xtracool/trs80-m1-drive-monitor/sa400_led_monitor/pdf/schematic.tex

% schematic.tex — one-page schematic of sa400_led_monitor v0.2.2, as built (JLCPCB r2 BOM).
% Hand-drawn with circuitikz from the netlist in gen/design.py; pin numbers are the DIP pins.
% Build:  lualatex schematic.tex   (pdf/build_test_plan.py does this and copies the PDF to docs/img/)
\documentclass[border=6pt]{standalone}
\usepackage{fontspec}
\setmainfont{DejaVu Sans}[Path=/usr/share/fonts/truetype/dejavu/,Extension=.ttf,UprightFont=*,BoldFont=*-Bold,ItalicFont=*-Oblique,BoldItalicFont=*-BoldOblique]
\usepackage[american]{circuitikz}
\usetikzlibrary{calc}
\ctikzset{bipoles/length=0.85cm, logic ports/scale=0.75, logic ports/fill=white}
\tikzset{every node/.style={font=\footnotesize}, pin/.style={font=\scriptsize, inner sep=1pt, text=black!70}}
\newcommand{\gnd}[1]{node[ground, scale=0.8]{}}
\begin{document}
\begin{circuitikz}[x=1cm, y=1cm]
% ===================================================================== title
\node[anchor=west, font=\normalsize\bfseries] at (0,2.3) {sa400\_led\_monitor v0.2.3 boards --- schematic, as built (r2 BOM)};
\node[anchor=west, font=\tiny, text=black!70] at (0,1.85) {Bus signals are active-low, open-collector, terminated 150~$\Omega$ at the last drive. This board: high-impedance tap, no terminators, never drives the bus. All gate pin numbers are DIP-14 pins.};

% ===================================================================== power
\draw[thick] (0,0.5) rectangle (1.0,-3.0);
\node[font=\scriptsize\bfseries] at (0.5,0.22) {J2};
\node[font=\tiny, rotate=90] at (0.42,-1.6) {Mate-N-Lok};
\foreach \y/\p/\n in {0/4/+5\,V, -0.6/3/RTN, -1.2/2/RTN, -2.4/1/+12\,V} {
  \draw (1.0,\y) -- (1.4,\y);
  \node[pin, anchor=east] at (0.97,\y) {\p};
}
\node[pin, anchor=south west] at (1.0,0.02) {+5\,V in};
\node[pin, anchor=north west] at (1.0,-2.42) {+12\,V in};
\node[pin, anchor=west] at (1.75,-0.9) {2, 3 RTN};
% returns
\draw (1.4,-0.6) -- (1.4,-1.2) -- (1.4,-1.45) \gnd{};
% +5 V chain
\draw (1.4,0) to[fuse, l=F1 PTC 0.5\,A] (3.2,0) -- (3.55,0);
\node[pigfete, bodydiode, rotate=90, yscale=-1] (q1) at (4.3,0.05) {};
\draw (3.55,0) -- (q1.D);
\node[pin, anchor=south] at ($(q1.D)+(0.05,0.08)$) {D};
\node[pin, anchor=south] at ($(q1.S)+(-0.05,0.08)$) {S};
\node[pin, anchor=east] at ($(q1.G)+(-0.05,0.25)$) {G};
\node[font=\scriptsize, anchor=south] at (4.3,0.78) {Q1 IRF4905 (P-ch) {\tiny --- reverse-polarity switch}};
\draw (q1.G) -- ($(q1.G)+(0,-0.25)$) \gnd{};
\draw (q1.S) -- (5.6,0) node[circ]{} node[pin, anchor=south east] {+5V} -- (13.0,0) node[vcc, scale=0.8]{+5\,V rail};
% clamp and decoupling
\draw (6.2,-2.0) to[zD, l_=D11 5V6] (6.2,0) node[circ]{};
\draw (6.2,-2.0) \gnd{};
\draw (8.2,0) node[circ]{} to[C, l=C6 100n] (8.2,-2.0) \gnd{};
\draw (10.1,0) node[circ]{} to[eC, l=C4 10$\mu$] (10.1,-2.0) \gnd{};
\draw (11.8,0) node[circ]{} to[R, l=R21 470] (11.8,-1.2) to[leD, l=D13 Y] (11.8,-2.3) \gnd{};
\node[pin, anchor=north] at (11.8,-2.75) {"5V"};
% +12 V indicator
\draw (1.4,-2.4) to[R, l_=R19 2k2] (2.7,-2.4) to[leD, l_=D12 Y] (3.9,-2.4) -- (4.3,-2.4) -- (4.3,-2.7) \gnd{};
\node[pin, anchor=north] at (4.3,-3.15) {"12V"};
\node[font=\tiny, text=black!70, anchor=north west, align=left] at (5.3,-3.15) {+12\,V lights D12 only --- nothing else on the board uses it.\\ +5\,V: J2-4 $\to$ F1 $\to$ Q1 $\to$ rail; D11 clamps the rail (74LS abs.\ max 7\,V).\\ C1, C2, C3 100n: pin 14 $\to$ pin 7 at U1, U2, U3 (not drawn).};

% ===================================================================== bus side: J1 bar
\draw[thick] (-0.1,-4.4) rectangle (0.9,-17.1);
\node[font=\scriptsize\bfseries, rotate=90] at (0.22,-6.8) {J1 34-pin card edge};
\node[font=\tiny, rotate=90, text=black!70, align=center] at (0.22,-12.0) {odd pins 3--31 = GND\\ even pins not listed: no copper\\ 1, 33: no connect};
\draw (0.9,-16.7) -- (1.3,-16.7) -- (1.3,-16.95) \gnd{};
\node[pin, anchor=south west] at (0.95,-16.68) {3,5,\dots,31};

% ===================================================================== WRITE GATE receiver
\draw (0.9,-4.9) node[pin, anchor=east] {24} -- (1.3,-4.9) to[R, l_=R14 470] (2.8,-4.9) node[circ] (wgin) {};
\draw (wgin) to[R, l_=R13 10k] (2.8,-3.7) node[vcc, scale=0.7]{+5\,V};
\node[invschmitt port] (u1wg) at (4.0,-4.9) {};
\draw (wgin) -- (u1wg.in 1);
\node[pin, anchor=south east] at ($(u1wg.in 1)+(0.12,0.04)$) {11};
\node[pin, anchor=south west] at ($(u1wg.out)+(-0.12,0.06)$) {10};
\node[font=\tiny, anchor=north] at (4.0,-5.35) {U1f 74LS14};
\draw (u1wg.out) -- (5.6,-4.9) node[circ]{} node[pin, anchor=south west]{WG (high = writing)};
\node[font=\tiny, text=black!70, anchor=south west] at (1.0,-4.85) {WG\_n};

% ===================================================================== four drive channels
% n / J1 pin / series R / pull-up / U1 in / U1 out / U3 in / U3 out / red LED / red R / NAND in1 / in2 / out / green LED / green R / gate letters
\foreach \n/\fp/\rs/\rp/\ia/\oa/\ib/\ob/\dr/\rr/\na/\nb/\no/\dg/\rg/\ga/\gb/\gc [count=\i] in
  {1/10/R17/R9/1/2/1/2/D1/R1/1/2/3/D5/R5/a/a/a,
   2/12/R16/R10/3/4/3/4/D2/R2/4/5/6/D6/R6/b/b/b,
   3/14/R15/R11/5/6/5/6/D3/R3/9/10/8/D7/R7/c/c/c,
   4/6/R18/R12/9/8/9/8/D4/R4/12/13/11/D8/R8/d/d/d} {
  \pgfmathsetmacro{\y}{-7.1 - (\i-1)*2.75}
  \pgfmathsetmacro{\yg}{\y - 1.35}
  % finger -> series R -> receiver node with pull-up
  \draw (0.9,\y) node[pin, anchor=east] {\fp} -- (1.3,\y) to[R, l_=\rs\ 470] (2.8,\y) node[circ] (in\n) {};
  \node[font=\tiny, text=black!70, anchor=south west] at (1.0,\y+0.05) {DS\n\_n};
  \draw (in\n) to[R, l_=\rp\ 10k] (2.8,\y+1.2) node[vcc, scale=0.7]{+5\,V};
  % U1 receiver
  \node[invschmitt port] (u1\n) at (4.0,\y) {};
  \draw (in\n) -- (u1\n.in 1);
  \node[pin, anchor=south east] at ($(u1\n.in 1)+(0.12,0.04)$) {\ia};
  \node[pin, anchor=south west] at ($(u1\n.out)+(-0.12,0.06)$) {\oa};
  \node[font=\tiny, anchor=north] at (4.0,\y-0.45) {U1\ga\ 74LS14};
  \draw (u1\n.out) -- (5.0,\y) node[circ] (ds\n) {} node[pin, anchor=south]{DS\n};
  % red: U3 open-collector inverter -> red LED -> R -> +5V
  \node[american not port] (u3\n) at (6.6,\y) {};
  \node[jump crossing, scale=2.4] (jc\n) at (5.6,\y) {};
  \draw (ds\n) -- (jc\n.west);  \draw (jc\n.east) -- (u3\n.in 1);
  \node[pin, anchor=south east] at ($(u3\n.in 1)+(0.12,0.04)$) {\ib};
  \node[pin, anchor=south west] at ($(u3\n.out)+(-0.12,0.06)$) {\ob};
  \node[font=\tiny, anchor=north] at (6.6,\y-0.45) {U3\gb\ 74LS06 (OC)};
  \draw (10.9,\y) node[vcc, scale=0.7]{+5\,V} to[R, l=\rr\ 470] (9.4,\y) to[leD, l=\dr\ RED] (u3\n.out);
  \node[pin, anchor=north] at (8.6,\y-0.25) {SEL \n};
  % green: NAND(DSn, WG) -> green LED -> R -> +5V
  \node[american nand port] (u2\n) at (6.6,\yg) {};
  \draw (ds\n) |- (u2\n.in 1);
  \draw (u2\n.in 2) -- (5.6,0 |- u2\n.in 2) node[circ]{};
  \node[pin, anchor=south east] at ($(u2\n.in 1)+(0.12,0.02)$) {\na};
  \node[pin, anchor=north east] at ($(u2\n.in 2)+(0.12,-0.02)$) {\nb};
  \node[pin, anchor=south west] at ($(u2\n.out)+(-0.12,0.06)$) {\no};
  \node[font=\tiny, anchor=north] at (6.6,\yg-0.5) {U2\gc\ 74LS00};
  \draw (10.9,\yg) node[vcc, scale=0.7]{+5\,V} to[R, l=\rg\ 470] (9.4,\yg) to[leD, l=\dg\ GRN] (u2\n.out);
  \node[pin, anchor=north] at (8.6,\yg-0.25) {WR \n};
}
% WG bus, hopping over each DSn -> U3 wire
\draw (5.6,-4.9) -- (jc1.north);
\draw (jc1.south) -- (jc2.north);
\draw (jc2.south) -- (jc3.north);
\draw (jc3.south) -- (jc4.north);
\draw (jc4.south) -- (5.6,-7.1-3*2.75-1.35-0.25);
% unused gates
\node[font=\tiny, text=black!70, anchor=north west, align=left] at (1.0,-17.5) {Unused: U1 pin 13 $\to$ GND (out 12 open); U3 pins 11, 13 $\to$ GND (outs 10, 12 open). Power: pin 14 = +5\,V, pin 7 = GND on U1--U3.\\ Drive $n$ on this board = TRS-80 drive :$n\!-\!1$. LED current $\approx (5 - 0.4 - V_f)/470 \approx 5.5$--$6.5$\,mA. Red = DS$n$; green = DS$n \cdot$ WG.};
\end{circuitikz}
\end{document}
