xtracool/trs80-m1-drive-monitor/sa400_led_monitor/output/ROUTE_REPORT.md

# Route report - sa400_led_monitor v0.2.4

- grid 1.27 mm, clearance 0.3 mm, signal 0.4 mm, power 0.6 mm
- segments: 250, vias: 45

| net | segments | vias | length mm |
|---|---|---|---|
| GND | 68 | 5 | 388.6 |
| +5V | 42 | 7 | 378.5 |
| +12V_IN | 4 | 1 | 55.9 |
| +5V_F | 4 | 0 | 14.0 |
| +5V_IN | 3 | 1 | 27.9 |
| DS1 | 9 | 2 | 109.2 |
| DS1_in | 7 | 0 | 44.4 |
| DS1_n | 1 | 0 | 7.6 |
| DS2 | 7 | 2 | 106.7 |
| DS2_in | 6 | 2 | 48.3 |
| DS2_n | 2 | 0 | 10.2 |
| DS3 | 9 | 1 | 110.5 |
| DS3_in | 8 | 3 | 61.0 |
| DS3_n | 3 | 0 | 12.7 |
| DS4 | 9 | 1 | 115.6 |
| DS4_in | 7 | 3 | 62.2 |
| DS4_n | 1 | 0 | 7.6 |
| GRN1_A | 1 | 0 | 10.2 |
| GRN1_K | 3 | 1 | 54.6 |
| GRN2_A | 1 | 0 | 10.2 |
| GRN2_K | 3 | 0 | 47.0 |
| GRN3_A | 1 | 0 | 10.2 |
| GRN3_K | 2 | 1 | 77.5 |
| GRN4_A | 1 | 0 | 10.2 |
| GRN4_K | 5 | 3 | 110.5 |
| LED12 | 2 | 1 | 14.0 |
| LED5 | 2 | 1 | 14.0 |
| RED1_A | 1 | 0 | 10.2 |
| RED1_K | 3 | 1 | 116.8 |
| RED2_A | 1 | 0 | 10.2 |
| RED2_K | 3 | 2 | 96.5 |
| RED3_A | 1 | 0 | 10.2 |
| RED3_K | 3 | 1 | 76.2 |
| RED4_A | 1 | 0 | 10.2 |
| RED4_K | 5 | 1 | 66.0 |
| WG | 14 | 4 | 137.2 |
| WG_in | 6 | 1 | 39.4 |
| WG_n | 1 | 0 | 7.6 |
| unconnected-(J1-DIR#-Pad18) | 0 | 0 | 0.0 |
| unconnected-(J1-GND-Pad1) | 0 | 0 | 0.0 |
| unconnected-(J1-GND-Pad33) | 0 | 0 | 0.0 |
| unconnected-(J1-INDEX#-Pad8) | 0 | 0 | 0.0 |
| unconnected-(J1-MOTOR_ON#-Pad16) | 0 | 0 | 0.0 |
| unconnected-(J1-RDATA#-Pad30) | 0 | 0 | 0.0 |
| unconnected-(J1-STEP#-Pad20) | 0 | 0 | 0.0 |
| unconnected-(J1-TRK00#-Pad26) | 0 | 0 | 0.0 |
| unconnected-(J1-WDATA#-Pad22) | 0 | 0 | 0.0 |
| unconnected-(J1-WPROT#-Pad28) | 0 | 0 | 0.0 |
| unconnected-(J1-spare-Pad2) | 0 | 0 | 0.0 |
| unconnected-(J1-spare-Pad32) | 0 | 0 | 0.0 |
| unconnected-(J1-spare-Pad34) | 0 | 0 | 0.0 |
| unconnected-(J1-spare-Pad4) | 0 | 0 | 0.0 |
| unconnected-(U1-6Y-Pad12) | 0 | 0 | 0.0 |
| unconnected-(U3-5Y-Pad10) | 0 | 0 | 0.0 |
| unconnected-(U3-6Y-Pad12) | 0 | 0 | 0.0 |
