xtracool/trs80-m1-drive-monitor/sa400_led_monitor/docs/img/fixtures.pdf

## D.1 Bus-simulator jig (“fake EI”) — used in Phase 2

Each monitored line is held high by 150 Ω (as the terminating drive does) and pulled to ground by a switch (as a 7438 in the EI does).
The monitor plugs onto the 3463. Ribbon conductor N = J1 pin N when the stripe is on contact 1 — check with the DMM before trusting the jig. 3M ³⁴⁶³⁻⁰⁰⁰¹ card⁻edge IDC

+5V_JIG bench supply 2 (or the same supply): 5.0 V, 50 mA limit

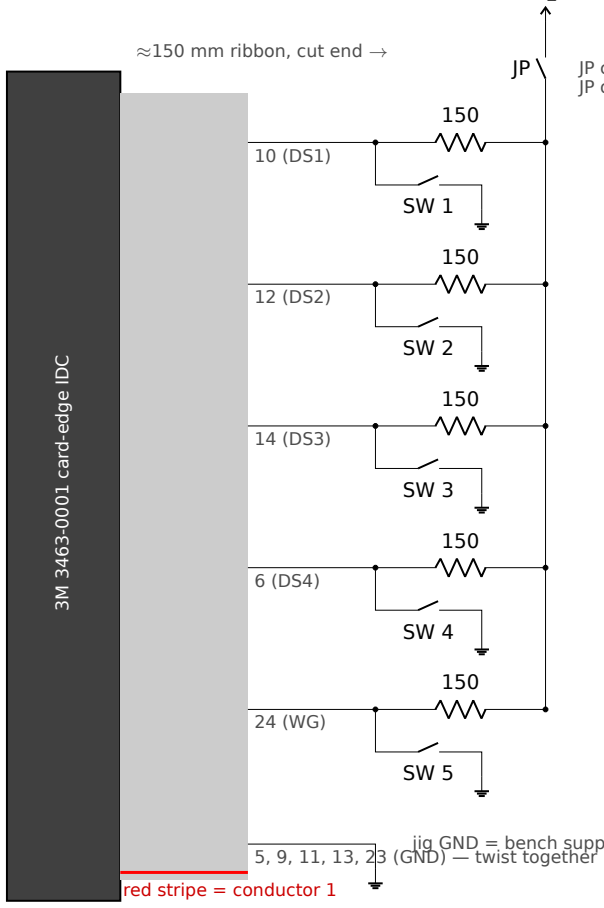
[picture p21: figure]
red stripe = conductor 1; ≈150 mm ribbon, cut end →; 5, 9, 11, 13, 23 (GND) — twist together

JP closed = pull-ups on (terminated bus)
JP open = the board’s own 10 k only

jig GND = bench supply (–) = the monitor supply’s (–): one common ground

Steps 2.6.2 and 2.8: mA meter in place of SW n (line to GND). Step 2.6.22: meter in series with that line’s 150 Ω. Any 34-way 0.1 in card-edge IDC and 28 AWG ribbon will do; parts in Appendix C.

## D.2 Power pigtail for J2 — used in Phases 2 and 3

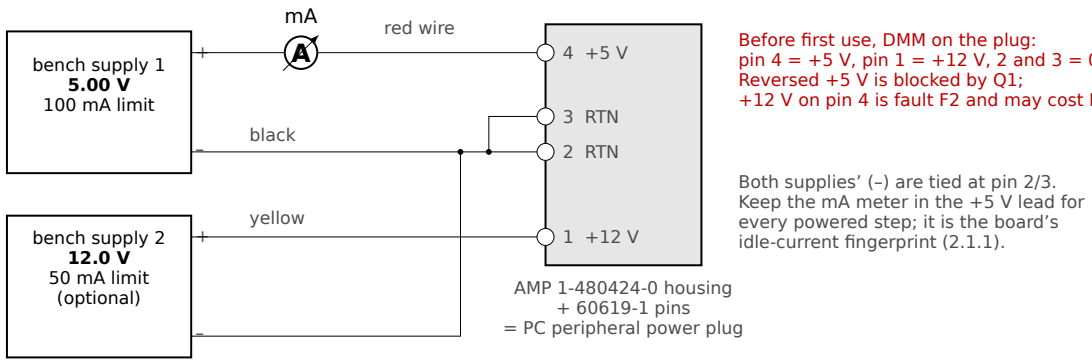
[picture p22: figure]
bench supply 1 5.00 V 100 mA limit; bench supply 2 12.0 V 50 mA limit (optional); 3 RTN; 2 RTN; AMP 1-480424-0 housing + 60619-1 pins = PC peripheral power plug; red wire; black; yellow; Before first use, DMM on the plug:; Reversed +5 V is blocked by Q1;; Both supplies’ (–) are tied at pin 2/3. Keep the mA meter in the +5 V lead for every powered step; it is the board’s idle-current fingerprint (2.1.1).

pin 4 = +5 V, pin 1 = +12 V, 2 and 3 = 0 V.

+12 V on pin 4 is fault F2 and may cost D11.

D.3 Key plug (optional) — 3M 3439-2 in the connector, opposite the board’s slot between fingers 4 and 6

34 32 30 28 26 24 22 20 18 16 14 12 10 8 | 6 | 4 | 2

slot

Board tab seen from the component side, fingers pointing away: pin 2 at the right, even pins on top, odd (GND) underneath. The 3439-2 pushes into the 3463’s contact cavity at that position; the connector then only fits the monitor one way. Without it, the stripe-to-pin-1 check in 3.0 is what prevents a reversed plug.
