xtracool/trs80-m1-drive-monitor/sa400_led_monitor/output/copper_top_bottom.png

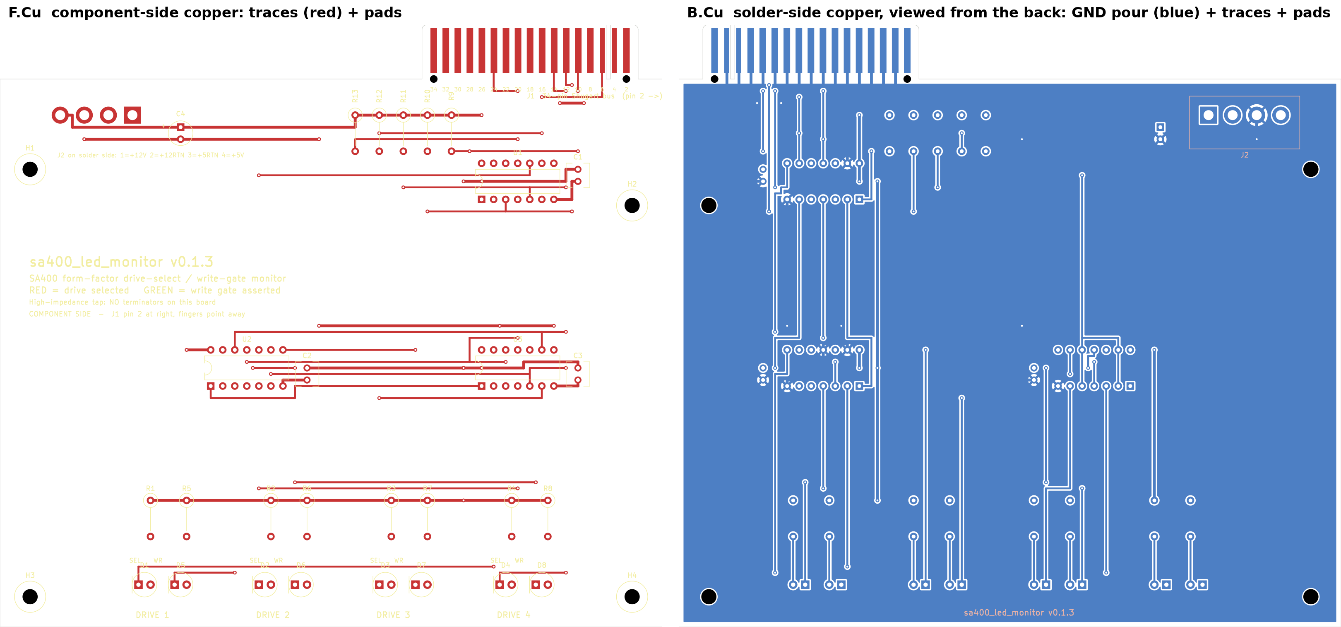
sa400_led_monitor/output/copper_top_bottom.png
