xtracool/trs80-m1-drive-monitor/sa400_led_monitor/output/j1_root_holes.png

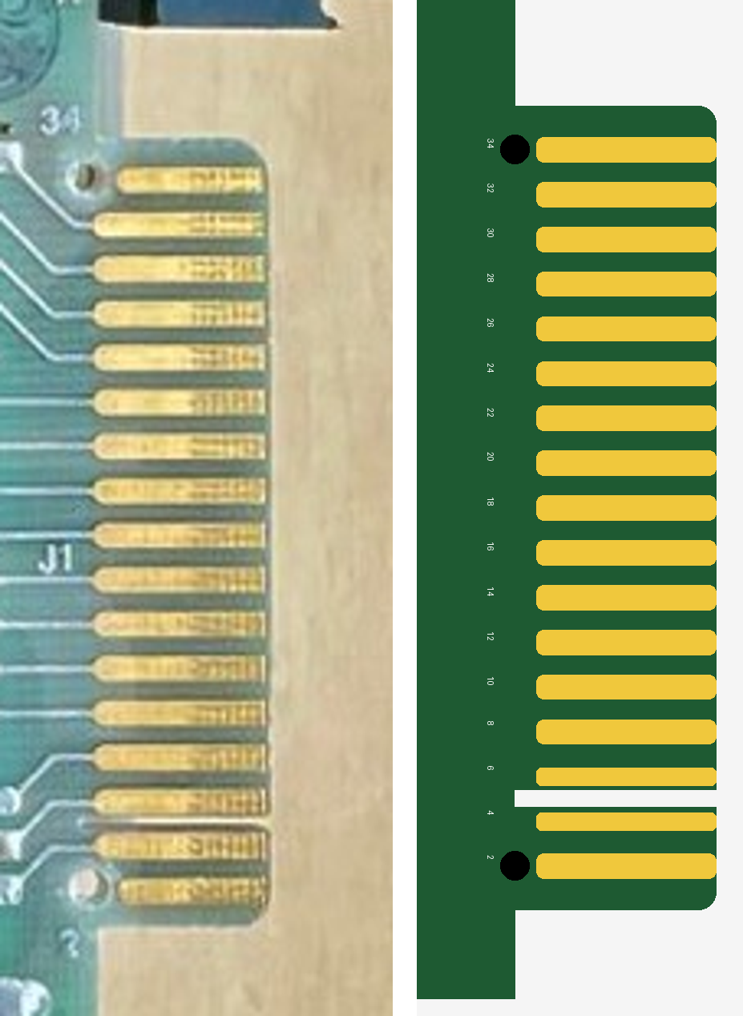
sa400_led_monitor/output/j1_root_holes.png
