xtracool/trs80-m1-drive-monitor/sa400_led_monitor/output/BOM.csv

Qty | References | Value | Footprint | Notes / source
4 | C1 C2 C3 C6 | 100nF | sa400:C_Disc_D5.0mm_P2.50mm | Ceramic disc 50 V, 2.5 mm pitch
1 | C4 | 10uF/16V | sa400:CP_Radial_D5.0mm_P2.50mm | Electrolytic radial 5 mm dia, 2.5 mm pitch
4 | D1 D2 D3 D4 | RED | sa400:LED_D5.0mm | 5 mm red LED, standard brightness e.g. Kingbright L-53ID (LCSC C598429); high-efficiency WP7113LID also fits (then use 1k5)
1 | D11 | 1N5339B | sa400:D_DO-15_P10.16mm_Vertical | Zener 5.6 V 5 W, DO-15 https://www.mouser.com/c/?q=1N5339B
2 | D12 D13 | YELLOW | sa400:LED_D5.0mm | 5 mm yellow LED, standard brightness e.g. Kingbright WP483YDT (LCSC C6001325)
4 | D5 D6 D7 D8 | GREEN | sa400:LED_D5.0mm | 5 mm green LED, standard brightness e.g. Kingbright WP7113GD (LCSC C7117617); high-efficiency WP7113LGD also fits (then use 1k5)
1 | F1 | PTC 0.5A | sa400:Fuse_Radial_P5.08mm | Radial PTC resettable fuse, 0.5 A hold / 1 A trip, 16 V+, 5.08 mm, e.g. Littelfuse RUEF050 https://www.mouser.com/c/?q=RUEF050
1 | J2 | AMP 1-641737-1 | sa400:MateNLok_4_RA | TE Commercial MATE-N-LOK 4-pos RIGHT-ANGLE header 1-641737-1 https://www.te.com/en/product-1-641737-1.html ; vertical 350211-1 (LCSC C305826) fits the same pads
1 | Q1 | IRF4905PBF | sa400:TO-220-3_Vertical | P-channel MOSFET, 55 V, 20 mOhm, TO-220 pins G-D-S (LCSC C2564) https://www.mouser.com/c/?q=IRF4905PBF ; onsemi NDP6020P is an equivalent G-D-S part
1 | R19 | 2k2 | sa400:R_Axial_DIN0207_P7.62mm_Vertical | 1/4 W axial. +12 V indicator series (~4.5 mA).
14 | R1 R2 R3 R4 R5 R6 R7 R8 R14 R15 R16 R17 R18 R21 | 470R | sa400:R_Axial_DIN0207_P7.62mm_Vertical | 1/4 W axial 5%. LED series (R1-R8, R21, ~5.5 mA) and bus series / fault-limiting (R14-R18).
5 | R9 R10 R11 R12 R13 | 10k | sa400:R_Axial_DIN0207_P7.62mm_Vertical | 1/4 W axial 5%
1 | U1 | 74LS14 | sa400:DIP-14_W7.62mm | TI SN74LS14N or equiv. DIP-14. https://www.ti.com/product/SN74LS14
1 | U2 | 74LS00 | sa400:DIP-14_W7.62mm | TI SN74LS00N or equiv. DIP-14. https://www.ti.com/product/SN74LS00
1 | U3 | 74LS06 | sa400:DIP-14_W7.62mm | TI SN74LS06N or equiv. DIP-14, open-collector. https://www.ti.com/product/SN74LS06
4 | H1 H2 H3 H4 | M3 standoff + screw | MountingHole_3.2mm_M3 | Standalone board mounting
3 | U1 U2 U3 (optional) | DIP-14 socket |  | Recommended for hand assembly
