xtracool/trs80-m1-drive-monitor/sa400_led_monitor/output/sa400_led_monitor.step

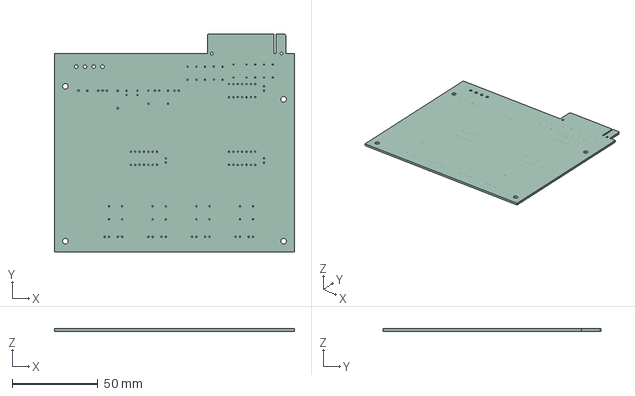
[picture p25: CAD file, 2026-10-20]
sa400_led_monitor/output/sa400_led_monitor.step
139.7 x 127.0 x 1.51 mm
