xtracool/trs80-m1-drive-monitor/sa400_led_monitor/pdf/sa400_led_monitor_test_plan_v1.6.tex

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

\usepackage{xcolor}
\usepackage{float}
\floatplacement{figure}{H}
\usepackage{pdflscape}
% blank verso pages (double-sided printing) carry a note instead of nothing
\makeatletter
\renewcommand{\cleardoublepage}{\clearpage\if@twoside\ifodd\c@page\else
  \null\vfill{\centering\small\textit{This page is intentionally blank (double-sided printing).}\par}\vfill\newpage\fi\fi}
\makeatother
\usepackage{fancyhdr}
\usepackage{lastpage}
\usepackage{etoolbox}
\newcommand{\tpfoot}{\fancyhf{}\renewcommand{\headrulewidth}{0pt}\renewcommand{\footrulewidth}{0.4pt}%
\fancyfoot[L]{\footnotesize TEST\_PLAN --- SA400 LED Monitor Test Plan · Version 1.6}%
\fancyfoot[R]{\footnotesize Created 2026-10-19 · Updated 2026-10-19 · Page \thepage\ of \pageref*{LastPage}}}
\pagestyle{fancy}\tpfoot
\fancypagestyle{plain}{\tpfoot}
\AtBeginEnvironment{longtable}{\footnotesize}
\AtBeginEnvironment{Shaded}{\footnotesize}
\setlength{\LTpre}{6pt}\setlength{\LTpost}{6pt}
\renewcommand{\arraystretch}{1.25}
\ifLuaTeX
  \usepackage{selnolig}  % disable illegal ligatures
\fi
\IfFileExists{bookmark.sty}{\usepackage{bookmark}}{\usepackage{hyperref}}
\IfFileExists{xurl.sty}{\usepackage{xurl}}{} % add URL line breaks if available
\urlstyle{same}
\hypersetup{
  colorlinks=true,
  linkcolor={blue},
  filecolor={Maroon},
  citecolor={Blue},
  urlcolor={blue},
  pdfcreator={LaTeX via pandoc}}

\author{}
\date{}

\begin{document}

\hypertarget{test-plan-sa400-drive-select-write-gate-led-monitor}{%
\section{Test Plan --- SA400 Drive-Select / Write-Gate LED
Monitor}\label{test-plan-sa400-drive-select-write-gate-led-monitor}}

Document: \texttt{TEST\_PLAN.md} · Project:
\texttt{sa400\_led\_monitor} · Test-plan version
\textbf{1.6} · created 2026-10-19 · updated 2026-10-19

Revisions: 1.1 populated-board drawing and legend · 1.2
design-review findings folded in (§0.7, 2.6.17, 2.7.2,
2.7.4, 3.2.5, 3.3.7, §4, §5.3) · 1.3 drawings moved to
appendices --- A.1 board wireframe, A.2 legend, B schematic,
C parts list --- each on its own sheet (blank back) for
double-sided printing · 1.4 Appendix D test-fixture drawings
(jig, power pigtail, key plug) and Appendix E cable drawing
· 1.5 J2 handedness check 1.1.6a before any power; J2 is
hand-fitted (JLCPCB left it off); repo workflow · 1.6 only
A.1, A.2, B and C have blank backs; D and E share a sheet

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

\begin{center}\rule{0.5\linewidth}{0.5pt}\end{center}

\hypertarget{read-this-first}{%
\subsection{0. Read this first}\label{read-this-first}}

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

\hypertarget{rules}{%
\subsubsection{0.2 Rules}\label{rules}}

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

\hypertarget{equipment}{%
\subsubsection{0.5 Equipment}\label{equipment}}

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

 Each signal conductor (x5):

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

\begin{center}\rule{0.5\linewidth}{0.5pt}\end{center}

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

\hypertarget{visual-and-mechanical}{%
\subsubsection{1.1 Visual and
mechanical}\label{visual-and-mechanical}}

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

DMM in ohms unless stated. ``OL'' = open / over-range.

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

This is the core ``cannot hurt the EI'' check with no power
applied.

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

Phase 1 done → record, go to Phase 2.

\begin{center}\rule{0.5\linewidth}{0.5pt}\end{center}

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

Expected currents (as built):

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

\hypertarget{rail-voltages}{%
\subsubsection{2.2 Rail voltages}\label{rail-voltages}}

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

\hypertarget{q1-voltage-drop}{%
\subsubsection{2.3 Q1 voltage drop}\label{q1-voltage-drop}}

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

\hypertarget{v-indicator}{%
\subsubsection{2.5 +12 V indicator}\label{v-indicator}}

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

\textbf{2.6.C --- Levels} (one channel, DS1 + WG closed, jig
pull-ups \textbf{on})

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

Phase 2 done → record, go to Phase 3 (board 1 first).

\begin{center}\rule{0.5\linewidth}{0.5pt}\end{center}

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

\hypertarget{before-starting}{%
\subsubsection{3.0 Before starting}\label{before-starting}}

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

\hypertarget{power-order-robustness}{%
\subsubsection{3.4 Power-order
robustness}\label{power-order-robustness}}

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

\hypertarget{soak}{%
\subsubsection{3.5 Soak}\label{soak}}

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

\hypertarget{final-power-source}{%
\subsubsection{3.6 Final power
source}\label{final-power-source}}

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

\begin{center}\rule{0.5\linewidth}{0.5pt}\end{center}

\hypertarget{if-something-fails}{%
\subsection{4. If something
fails}\label{if-something-fails}}

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

\begin{center}\rule{0.5\linewidth}{0.5pt}\end{center}

\clearpage\renewcommand{\arraystretch}{2.1}
\hypertarget{record-sheets}{%
\subsection{5. Record sheets}\label{record-sheets}}

Tick ✓ or write the reading. One column per board.

\hypertarget{phase-1}{%
\subsubsection{5.1 Phase 1}\label{phase-1}}

\begin{longtable}[]{@{}
  >{\raggedright\arraybackslash}p{(\columnwidth - 10\tabcolsep) * \real{0.6250}}
  >{\raggedright\arraybackslash}p{(\columnwidth - 10\tabcolsep) * \real{0.0750}}
  >{\raggedright\arraybackslash}p{(\columnwidth - 10\tabcolsep) * \real{0.0750}}
  >{\raggedright\arraybackslash}p{(\columnwidth - 10\tabcolsep) * \real{0.0750}}
  >{\raggedright\arraybackslash}p{(\columnwidth - 10\tabcolsep) * \real{0.0750}}
  >{\raggedright\arraybackslash}p{(\columnwidth - 10\tabcolsep) * \real{0.0750}}@{}}
\toprule\noalign{}
\begin{minipage}[b]{\linewidth}\raggedright
Step
\end{minipage} & \begin{minipage}[b]{\linewidth}\raggedright
B1
\end{minipage} & \begin{minipage}[b]{\linewidth}\raggedright
B2
\end{minipage} & \begin{minipage}[b]{\linewidth}\raggedright
B3
\end{minipage} & \begin{minipage}[b]{\linewidth}\raggedright
B4
\end{minipage} & \begin{minipage}[b]{\linewidth}\raggedright
B5
\end{minipage} \\
\midrule\noalign{}
\endhead
\bottomrule\noalign{}
\endlastfoot
1.1.1--1.1.8 visual & & & & & \\
1.1.9 thickness (mm) & & & & & \\
1.1.10--1.1.11 fit & & & & & \\
\textcolor[HTML]{0040A0}{1.1.6a J2: yellow→+12V first try?
side fitted} & & & & & \\
1.1.12 tab-corner / key / J2 drill (mm) & & & & & \\
1.2.1 +12↔+5 OL & & & & & \\
1.2.4 J2-4↔GND (Ω) & & & & & \\
1.2.6 F1 (Ω) & & & & & \\
1.3.1 Q1 body diode (V) & & & & & \\
1.3.4 GND↔rail diode (V) & & & & & \\
1.4.1--1.4.2 no-connect fingers OL & & & & & \\
1.4.3 GND fingers & & & & & \\
1.4.4 series R (Ω) 10/12/14/6/24 & & & & & \\
1.4.5 finger→rail (kΩ) 10/12/14/6/24 & & & & & \\
1.4.8 fingers↔+12 OL & & & & & \\
1.5 LEDs & & & & & \\
\end{longtable}

\hypertarget{phase-2}{%
\subsubsection{5.2 Phase 2}\label{phase-2}}

\begin{longtable}[]{@{}
  >{\raggedright\arraybackslash}p{(\columnwidth - 10\tabcolsep) * \real{0.6250}}
  >{\raggedright\arraybackslash}p{(\columnwidth - 10\tabcolsep) * \real{0.0750}}
  >{\raggedright\arraybackslash}p{(\columnwidth - 10\tabcolsep) * \real{0.0750}}
  >{\raggedright\arraybackslash}p{(\columnwidth - 10\tabcolsep) * \real{0.0750}}
  >{\raggedright\arraybackslash}p{(\columnwidth - 10\tabcolsep) * \real{0.0750}}
  >{\raggedright\arraybackslash}p{(\columnwidth - 10\tabcolsep) * \real{0.0750}}@{}}
\toprule\noalign{}
\begin{minipage}[b]{\linewidth}\raggedright
Step
\end{minipage} & \begin{minipage}[b]{\linewidth}\raggedright
B1
\end{minipage} & \begin{minipage}[b]{\linewidth}\raggedright
B2
\end{minipage} & \begin{minipage}[b]{\linewidth}\raggedright
B3
\end{minipage} & \begin{minipage}[b]{\linewidth}\raggedright
B4
\end{minipage} & \begin{minipage}[b]{\linewidth}\raggedright
B5
\end{minipage} \\
\midrule\noalign{}
\endhead
\bottomrule\noalign{}
\endlastfoot
2.1.1 idle current (mA) & & & & & \\
2.2.2 rail (V) & & & & & \\
2.3.1 Q1 drop (V) & & & & & \\
2.4.1 works at 4.75 V & & & & & \\
2.4.2 current at 5.25 V (mA) & & & & & \\
2.5.1 +12 current (mA) & & & & & \\
2.6.1 line open V (min/max) & & & & & \\
2.6.2 line short mA (max) & & & & & \\
2.6.5--2.6.15 truth table, pull-ups off & & & & & \\
2.6.5--2.6.15 truth table, pull-ups on & & & & & \\
2.6.20 LED resistor V & & & & & \\
2.6.22 dead-board line current (mA) & & & & & \\
2.6.23 back-fed rail (V) & & & & & \\
2.7.1 reverse +5 (mA) & & --- & --- & --- & --- \\
2.7.3 rail at 300 mA (V) & & --- & --- & --- & --- \\
2.7.4 PTC trip (optional) & & --- & --- & --- & --- \\
2.8.1 fault current (mA) & & --- & --- & --- & --- \\
\end{longtable}

\hypertarget{phase-3}{%
\subsubsection{5.3 Phase 3}\label{phase-3}}

\begin{longtable}[]{@{}
  >{\raggedright\arraybackslash}p{(\columnwidth - 10\tabcolsep) * \real{0.6250}}
  >{\raggedright\arraybackslash}p{(\columnwidth - 10\tabcolsep) * \real{0.0750}}
  >{\raggedright\arraybackslash}p{(\columnwidth - 10\tabcolsep) * \real{0.0750}}
  >{\raggedright\arraybackslash}p{(\columnwidth - 10\tabcolsep) * \real{0.0750}}
  >{\raggedright\arraybackslash}p{(\columnwidth - 10\tabcolsep) * \real{0.0750}}
  >{\raggedright\arraybackslash}p{(\columnwidth - 10\tabcolsep) * \real{0.0750}}@{}}
\toprule\noalign{}
\begin{minipage}[b]{\linewidth}\raggedright
Step
\end{minipage} & \begin{minipage}[b]{\linewidth}\raggedright
B1
\end{minipage} & \begin{minipage}[b]{\linewidth}\raggedright
B2
\end{minipage} & \begin{minipage}[b]{\linewidth}\raggedright
B3
\end{minipage} & \begin{minipage}[b]{\linewidth}\raggedright
B4
\end{minipage} & \begin{minipage}[b]{\linewidth}\raggedright
B5
\end{minipage} \\
\midrule\noalign{}
\endhead
\bottomrule\noalign{}
\endlastfoot
3.1 ground offset (V DC / AC) & & & & & \\
3.2.1--3.2.4 EI only & & & & & \\
\textcolor[HTML]{0040A0}{3.2.5 U1-1, no drives (V)} & & & &
& \\
3.3.1--3.3.5 with drives & & & & & \\
\textcolor[HTML]{0040A0}{3.3.7 U1-1, with drives (V) →
HCT14?} & & & & & \\
3.3.6 scope delta (mV) & & & & & \\
3.4.1--3.4.4 power order & & & & & \\
3.5 soak / heat / current & & & & & \\
3.6 final supply & & & & & \\
\end{longtable}

\begin{center}\rule{0.5\linewidth}{0.5pt}\end{center}

\renewcommand{\arraystretch}{1.25}
\hypertarget{todo}{%
\subsection{6. TODO}\label{todo}}

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

\begin{center}\rule{0.5\linewidth}{0.5pt}\end{center}

\cleardoublepage
\hypertarget{appendix-a-board-drawing}{%
\subsection{Appendix A --- Board
drawing}\label{appendix-a-board-drawing}}

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

\cleardoublepage
\hypertarget{appendix-b-schematic}{%
\subsection{Appendix B ---
Schematic}\label{appendix-b-schematic}}

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

\end{landscape}
\end{document}
