xtracool/trs80-m1-drive-monitor/sa400_led_monitor/kicad/sa400_led_monitor.kicad_pcb

## KiCad design sa400_led_monitor/kicad/sa400_led_monitor.kicad_pcb (2026-10-20)

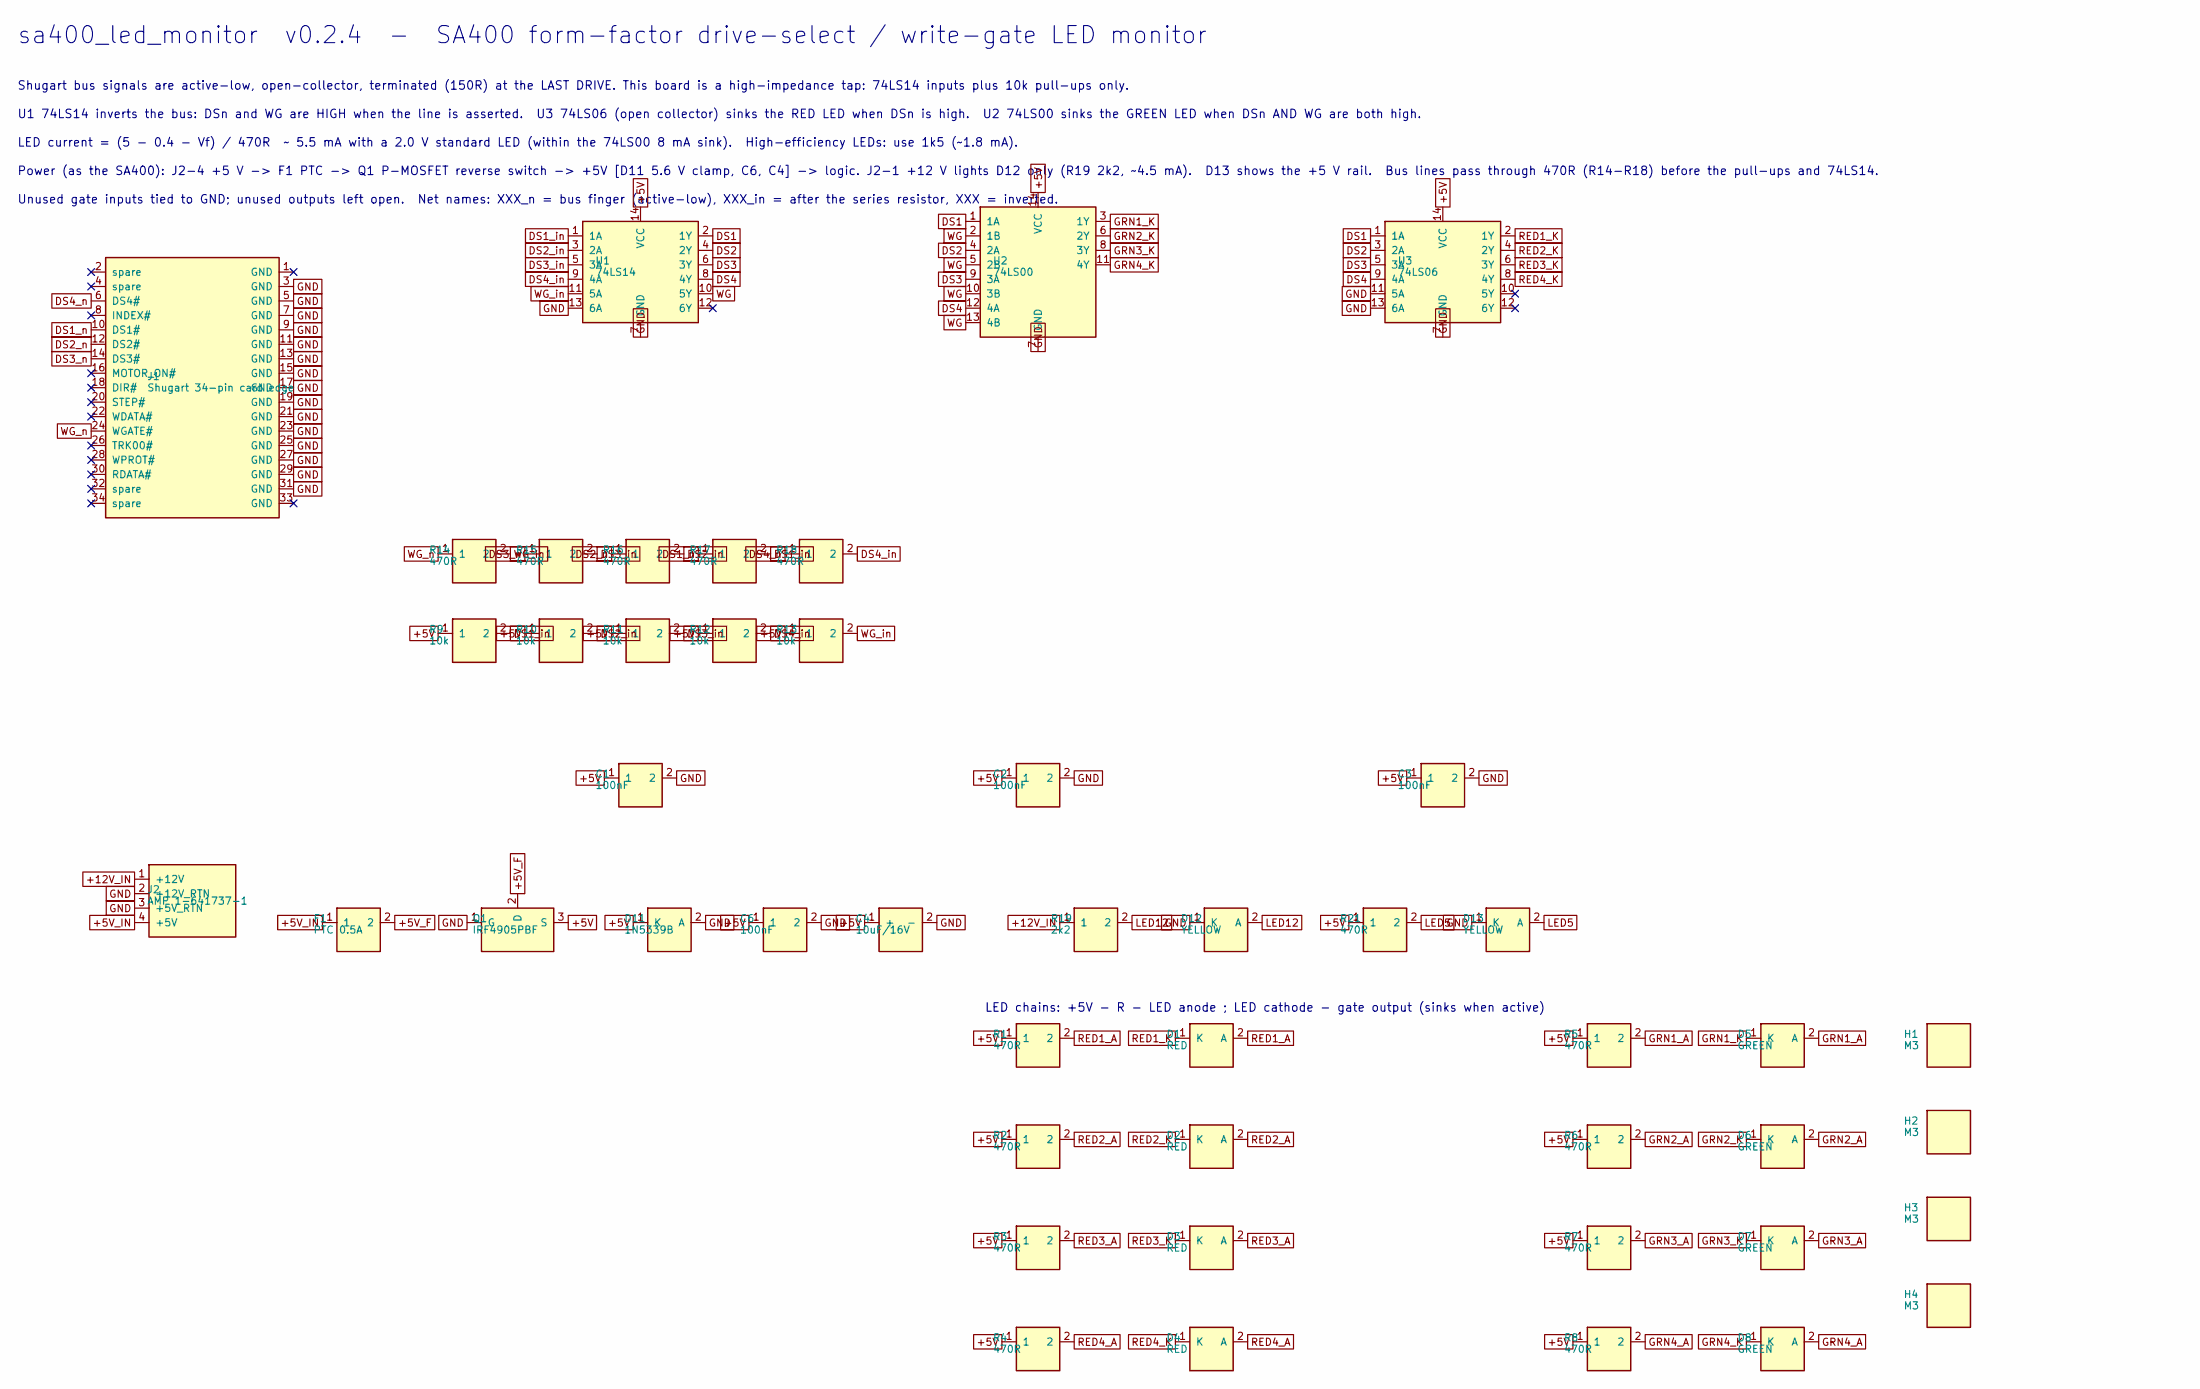
[picture p34: schematic sa400_led_monitor.kicad_sch, SA400 form-factor drive-select / write-gate LED monitor]

Parts:
C1, C2, C3, C6: 100nF; C_Disc_D5.0mm_P2.50mm
C4: 10uF/16V; CP_Radial_D5.0mm_P2.50mm
D1, D2, D3, D4: RED; LED_D5.0mm
D5, D6, D7, D8: GREEN; LED_D5.0mm
D11: 1N5339B; D_DO-15_P10.16mm_Vertical
D12, D13: YELLOW; LED_D5.0mm
F1: PTC 0.5A; Fuse_Radial_P5.08mm
H1, H2, H3, H4: M3; MountingHole_3.2mm_M3
J1: Shugart 34-pin card edge; CardEdge_34_SA400
J2: AMP 1-641737-1; MateNLok_4_RA
Q1: IRF4905PBF; TO-220-3_Vertical
R1, R2, R3, R4, R5, R6, R7, R8, R14, R15, R16, R17, R18, R21: 470R; R_Axial_DIN0207_P7.62mm_Vertical
R9, R10, R11, R12, R13: 10k; R_Axial_DIN0207_P7.62mm_Vertical
R19: 2k2; R_Axial_DIN0207_P7.62mm_Vertical
U1: 74LS14; DIP-14_W7.62mm
U2: 74LS00; DIP-14_W7.62mm
U3: 74LS06; DIP-14_W7.62mm

Connections:
+5V: C1.1, C2.1, C3.1, C4.1 (+), C6.1, D11.1 (K), Q1.3 (S), R1.1, R2.1, R3.1, R4.1, R5.1, R6.1, R7.1, R8.1, R9.1, R10.1, R11.1, R12.1, R13.1, R21.1, U1.14 (VCC), U2.14 (VCC), U3.14 (VCC)
+5V_F: F1.2, Q1.2 (D)
+5V_IN: F1.1, J2.4 (+5V)
+12V_IN: J2.1 (+12V), R19.1
DS1: U1.2 (1Y), U2.1 (1A), U3.1 (1A)
DS1_in: R9.2, R17.2, U1.1 (1A)
DS1_n: J1.10 (DS1#), R17.1
DS2: U1.4 (2Y), U2.4 (2A), U3.3 (2A)
DS2_in: R10.2, R16.2, U1.3 (2A)
DS2_n: J1.12 (DS2#), R16.1
DS3: U1.6 (3Y), U2.9 (3A), U3.5 (3A)
DS3_in: R11.2, R15.2, U1.5 (3A)
DS3_n: J1.14 (DS3#), R15.1
DS4: U1.8 (4Y), U2.12 (4A), U3.9 (4A)
DS4_in: R12.2, R18.2, U1.9 (4A)
DS4_n: J1.6 (DS4#), R18.1
GND: C1.2, C2.2, C3.2, C4.2 (-), C6.2, D11.2 (A), D12.1 (K), D13.1 (K), J1.3 (GND), J1.5 (GND), J1.7 (GND), J1.9 (GND), J1.11 (GND), J1.13 (GND), J1.15 (GND), J1.17 (GND), J1.19 (GND), J1.21 (GND), J1.23 (GND), J1.25 (GND), J1.27 (GND), J1.29 (GND), J1.31 (GND), J2.2 (+12V_RTN), J2.3 (+5V_RTN), Q1.1 (G), U1.7 (GND), U1.13 (6A), U2.7 (GND), U3.7 (GND), U3.11 (5A), U3.13 (6A)
GRN1_A: D5.2 (A), R5.2
GRN1_K: D5.1 (K), U2.3 (1Y)
GRN2_A: D6.2 (A), R6.2
GRN2_K: D6.1 (K), U2.6 (2Y)
GRN3_A: D7.2 (A), R7.2
GRN3_K: D7.1 (K), U2.8 (3Y)
GRN4_A: D8.2 (A), R8.2
GRN4_K: D8.1 (K), U2.11 (4Y)
LED5: D13.2 (A), R21.2
LED12: D12.2 (A), R19.2
RED1_A: D1.2 (A), R1.2
RED1_K: D1.1 (K), U3.2 (1Y)
RED2_A: D2.2 (A), R2.2
RED2_K: D2.1 (K), U3.4 (2Y)
RED3_A: D3.2 (A), R3.2
RED3_K: D3.1 (K), U3.6 (3Y)
RED4_A: D4.2 (A), R4.2
RED4_K: D4.1 (K), U3.8 (4Y)
WG: U1.10 (5Y), U2.2 (1B), U2.5 (2B), U2.10 (3B), U2.13 (4B)
WG_in: R13.2, R14.2, U1.11 (5A)
WG_n: J1.24 (WGATE#), R14.1

Notes on the sheet:
sa400_led_monitor v0.2.4 - SA400 form-factor drive-select / write-gate LED monitor
Shugart bus signals are active-low, open-collector, terminated (150R) at the LAST DRIVE. This board is a high-impedance tap: 74LS14 inputs plus 10k pull-ups only.
U1 74LS14 inverts the bus: DSn and WG are HIGH when the line is asserted. U3 74LS06 (open collector) sinks the RED LED when DSn is high. U2 74LS00 sinks the GREEN LED when DSn AND WG are both high.
LED current = (5 - 0.4 - Vf) / 470R ~ 5.5 mA with a 2.0 V standard LED (within the 74LS00 8 mA sink). High-efficiency LEDs: use 1k5 (~1.8 mA).
Power (as the SA400): J2-4 +5 V -> F1 PTC -> Q1 P-MOSFET reverse switch -> +5V [D11 5.6 V clamp, C6, C4] -> logic. J2-1 +12 V lights D12 only (R19 2k2, ~4.5 mA). D13 shows the +5 V rail. Bus lines pass through 470R (R14-R18) before the pull-ups and 74LS14.
Unused gate inputs tied to GND; unused outputs left open. Net names: XXX_n = bus finger (active-low), XXX_in = after the series resistor, XXX = inverted.
LED chains: +5V - R - LED anode ; LED cathode - gate output (sinks when active)

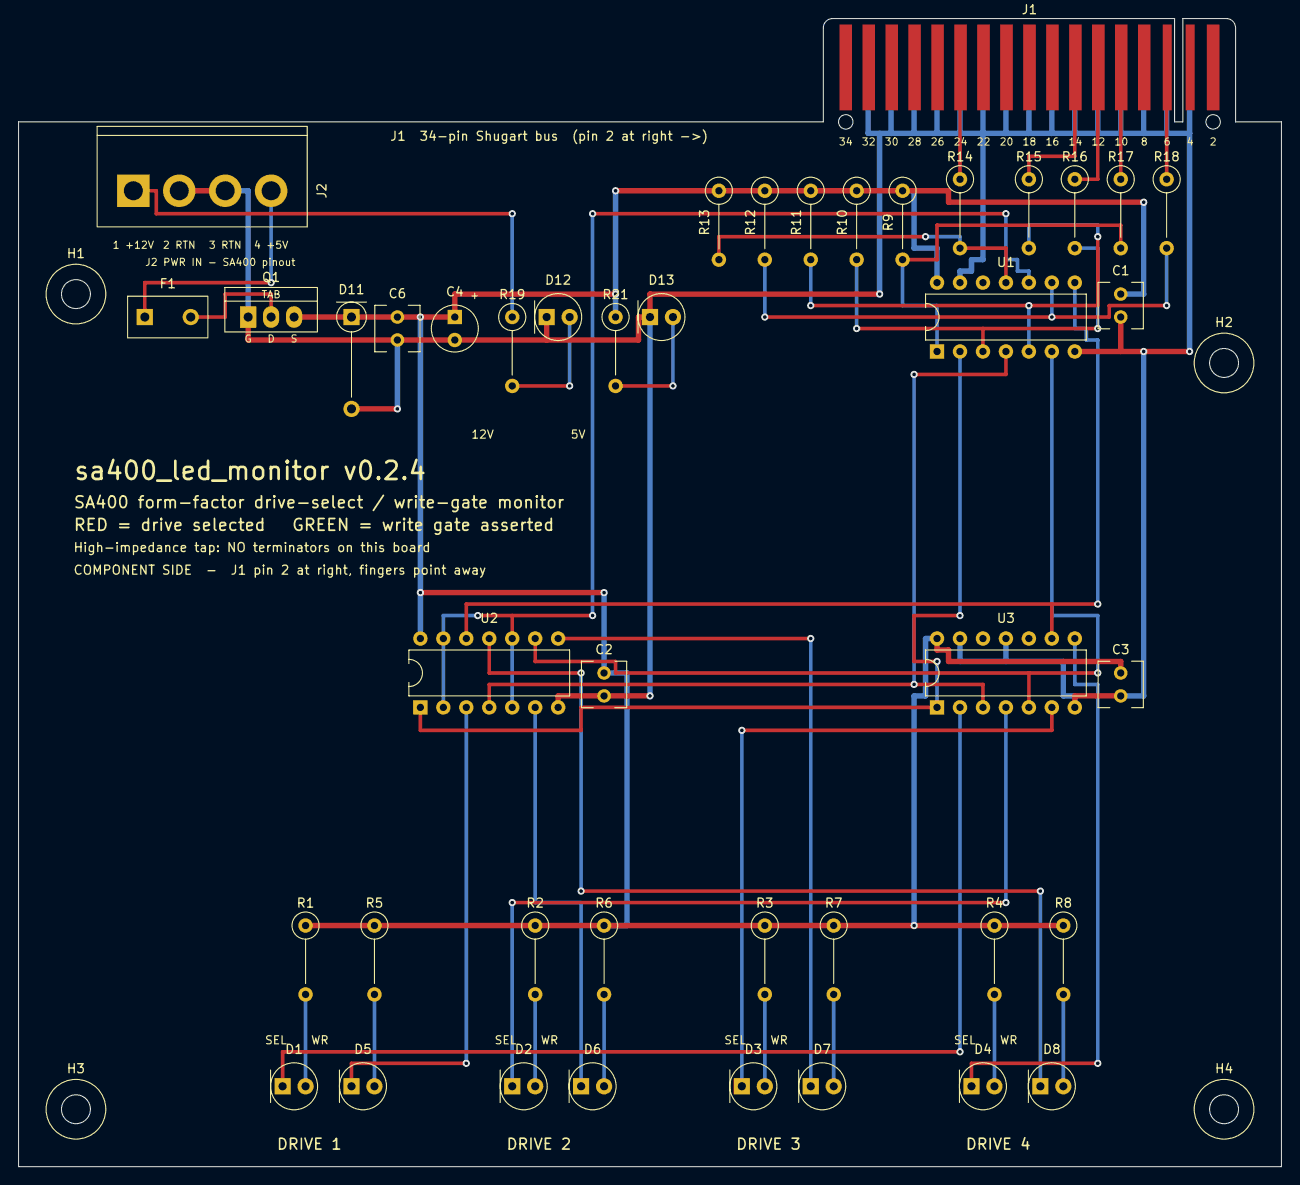
[picture p35: board sa400_led_monitor.kicad_pcb from above]

Board: 2 copper layers, 139.7 x 127.0 mm, 47 parts (0 on the bottom side), 38 nets.
