xtracool/trs80-m1-drive-monitor/(commit log)

2026-10-20 v0.2.4 design + test plan v1.4: initial import of the TRS-80 M1 / Shugart drive monitor
    Snapshot of C:\Users\ven\Desktop\Projects\_claude\sa400-led-monitor on 2026-10-19.
    verify.py clean (DRC 0/0/0, ERC 0, 47/47 links) with KiCad 10.0.6.
    Claude-Session: https://claude.ai/code/session_018xTgKfw1aTGL6EGg7RGDGm
    [BOM.csv, BOM_jlcpcb.csv, BOM_jlcpcb_v0.2.2_r2.csv, BOM_jlcpcb_v0.2.3.csv, BOM_jlcpcb_v0.2.4.csv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]
2026-10-20 testplan v1.5: J2 handedness check 1.1.6a before any power; J2 hand-fitted (JLCPCB left it off)
    - TEST_PLAN.md: 1.1.6a procedure (header in holes unsoldered, plug on, yellow wire -> "+12V" square pad;
    pass = solder on the solder side, fail = fit on the component side, record it for v0.2.4 J2_PIN1_X /
    J2_PIN_DIR); 1.1.6 now "J2 fitted by hand after 1.1.6a"; applies-to, 0.4, legend, parts list and
    record sheet updated; repo noted as the hand-off point.
    - Board drawing frozen as docs/img/board_populated_v0.2.3.* (the boards in hand); render_populated.py
    now names its output by config.VERSION and draws J2 solid when it is on the component side;
    build_test_plan.py uses the frozen drawin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
2026-10-20 testplan v1.6: appendix D and E share a sheet; only A.1, A.2, B and C have blank backs
    - build_test_plan.py: Appendix E (cable, landscape) follows D with a plain page break instead of
    starting a new sheet. 26 pages. Top-level PDF replaced with v1.6.
    Claude-Session: https://claude.ai/code/session_0134fC6kcCtdBZGMquqQza41
2026-10-20 testplan v1.7: renamed for the repo; §1.0 explains the unpowered meter checks; revision history -> Appendix F
    - PDF is now pdf/trs80-m1-drive-monitor_test_plan_v<ver>.pdf (+ top-level copy); title "Test Plan —
    TRS-80 Model I / Shugart Drive Monitor"; footer carries the repo name.
    - New §1.0: how ohms / continuity / diode mode work on an unpowered board (the meter is the source,
    ~1 mA, readings in 1.3 and 1.5 are forward drops), red-probe polarity check, and what to do with a
    meter that has no diode mode. 1.3 and 1.5 point to it.
    - The header's "Revisions:" line moved to Appendix F (table, 1.0–1.7).
    - Note for the design session: top-level README.md still names sa400_led_monitor_t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
